ariporad/PIE-MiniProject2/images/graph.jpg

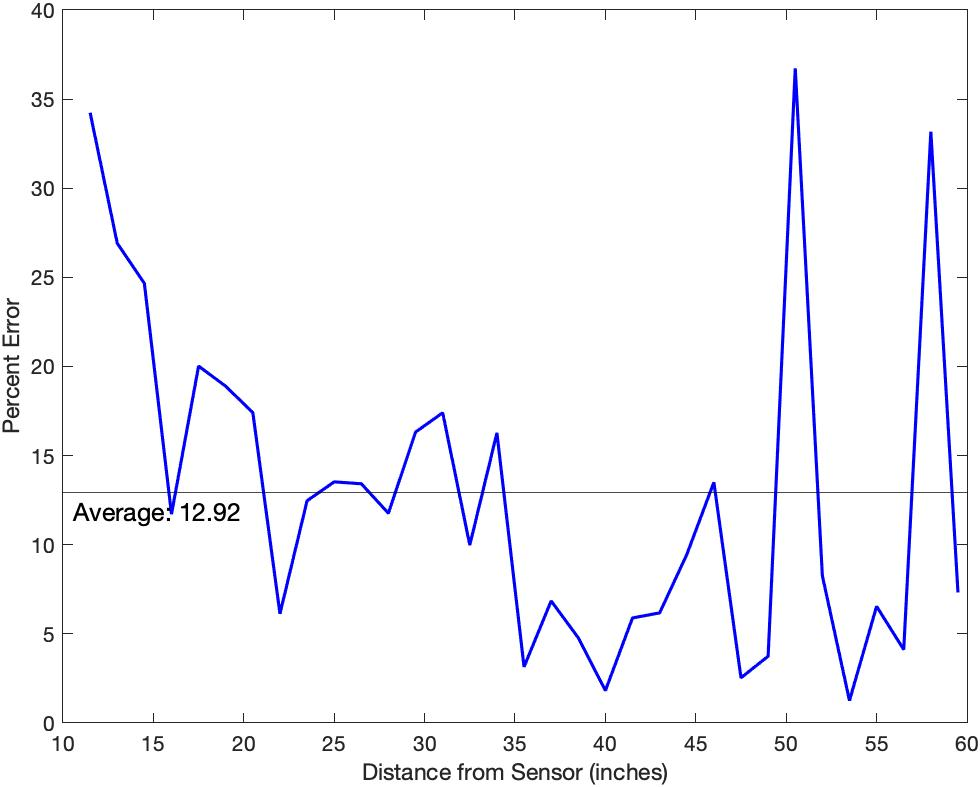
images/graph.jpg
