ariporad/PIE-MiniProject2/SW_files/inspiration.png

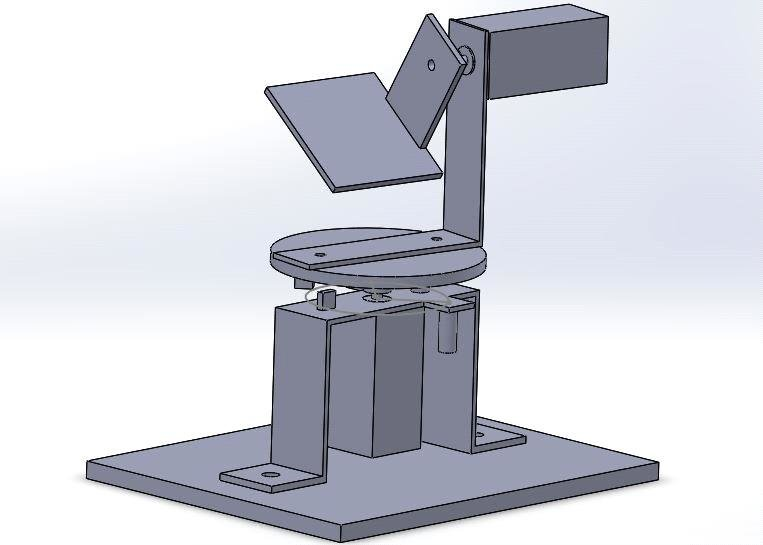
SW_files/inspiration.png
