ariporad/PIE-MiniProject2/SW_files/SensorAssem.SLDASM

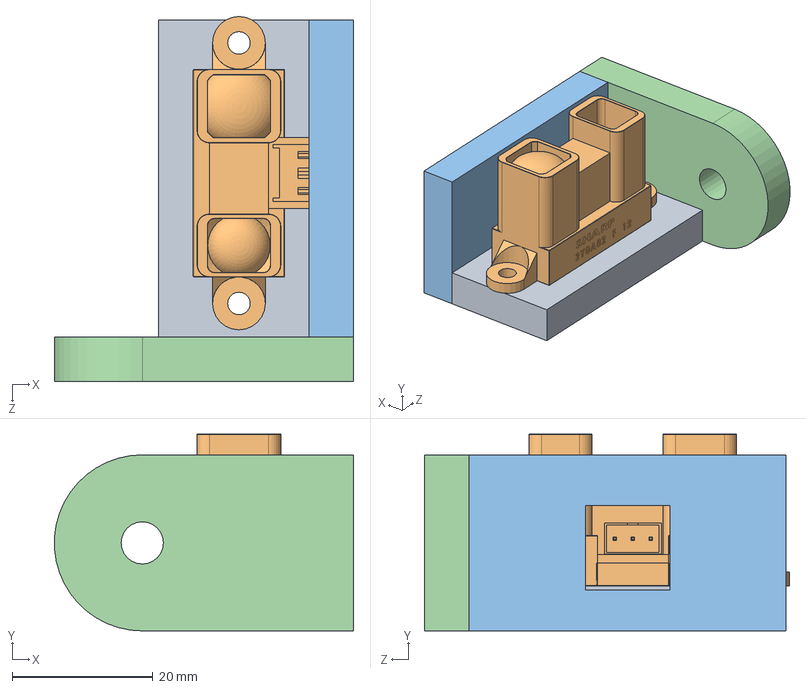
[picture p10: CAD file, 2021-09-24]
SW_files/SensorAssem.SLDASM
42.5 x 28.0 x 51.8 mm
SensorBack
SensorBottom
yServoSensorConnection
