ariporad/PIE-MiniProject2/SW_files/xServoBoxAssem.SLDASM

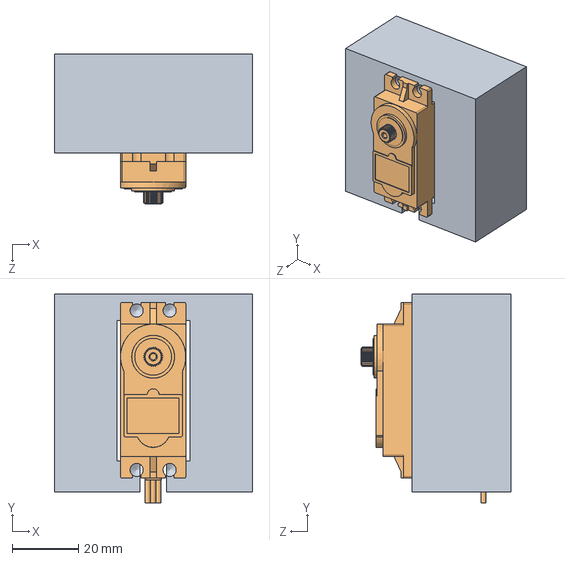
[picture p11: CAD file, 2021-09-24]
SW_files/xServoBoxAssem.SLDASM
60.0 x 63.3 x 45.4 mm
