ariporad/PIE-MiniProject2/SW_files/yServoAssem.SLDASM

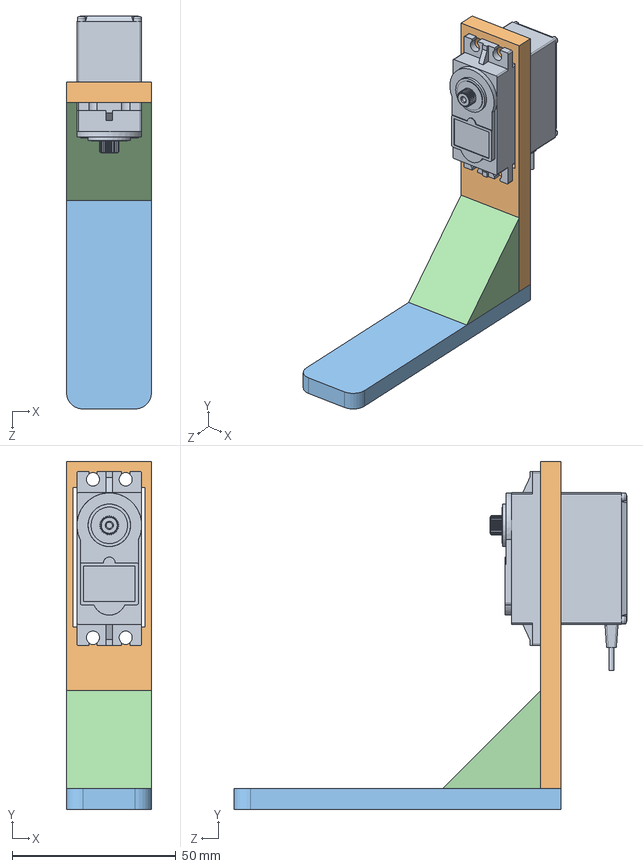
[picture p12: CAD file, 2021-09-24]
SW_files/yServoAssem.SLDASM
26.0 x 106.3 x 120.1 mm
yServoMount
xServoPlate
support
