ariporad/PIE-MiniProject2/SW_files/support.sldprt

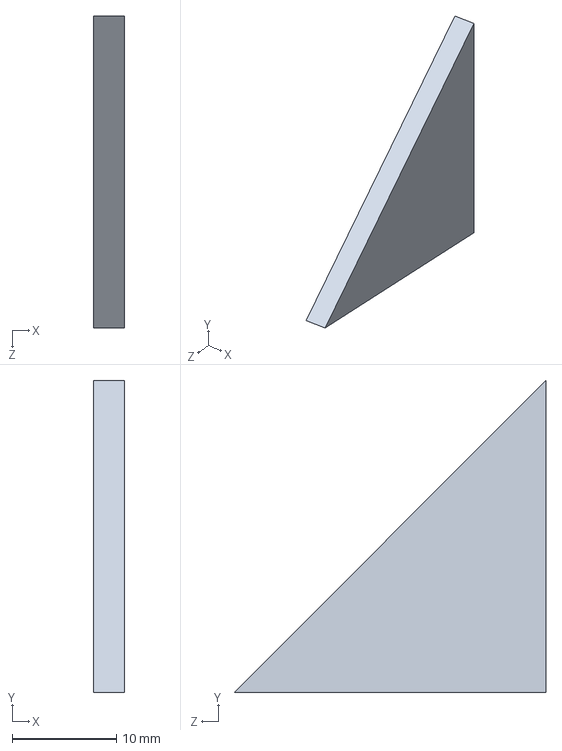
[picture p13: CAD file, 2021-09-24]
SW_files/support.sldprt
3.00 x 30.0 x 30.0 mm
