ariporad/PIE-MiniProject2/SW_files/ServoAssem.STL

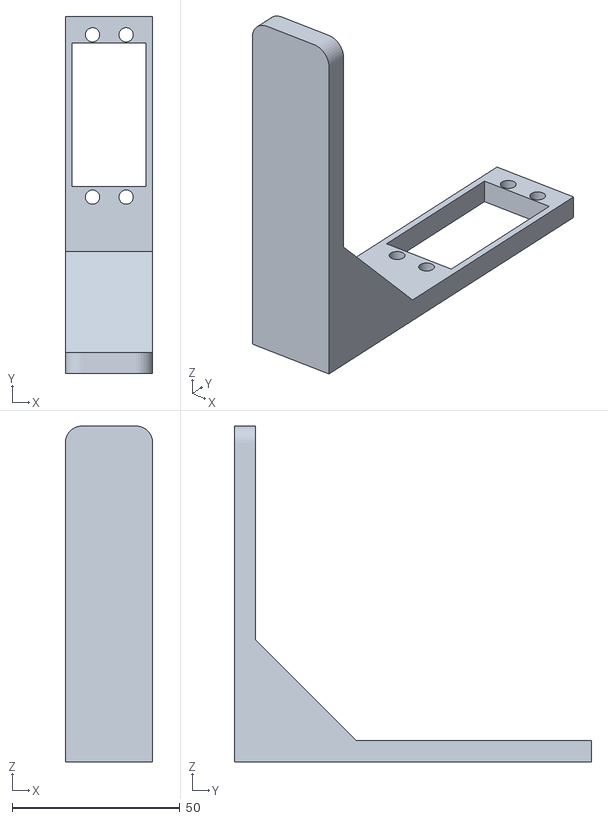
[picture p14: CAD file, 2021-09-24]
SW_files/ServoAssem.STL
26.0 x 106.3 x 100.0
