ariporad/PIE-MiniProject2/SW_files/xServoPlate.sldprt

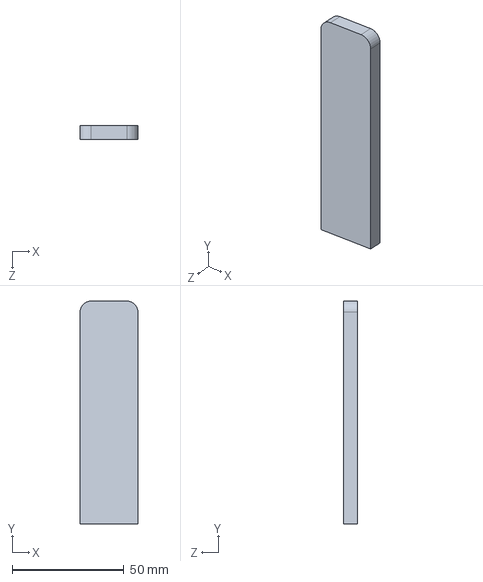
[picture p15: CAD file, 2021-09-24]
SW_files/xServoPlate.sldprt
26.0 x 100.0 x 6.35 mm
