ariporad/PIE-MiniProject2/SW_files/yServoMount.sldprt

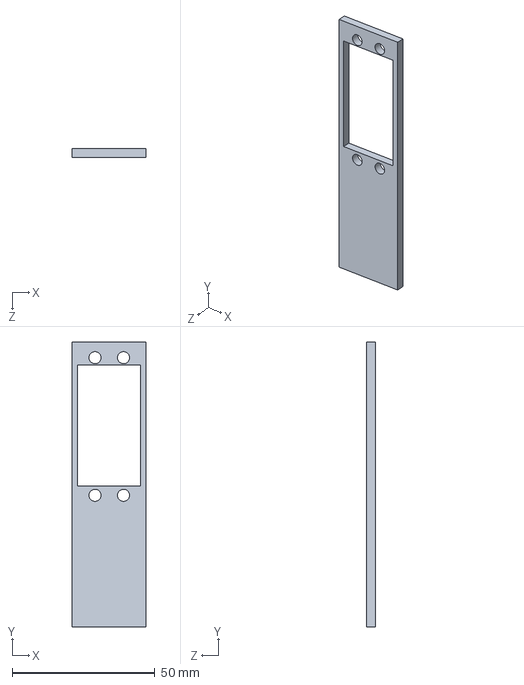
[picture p16: CAD file, 2021-09-24]
SW_files/yServoMount.sldprt
26.0 x 100.0 x 3.00 mm
