ariporad/PIE-MiniProject2/SW_files/xServoBox.sldprt

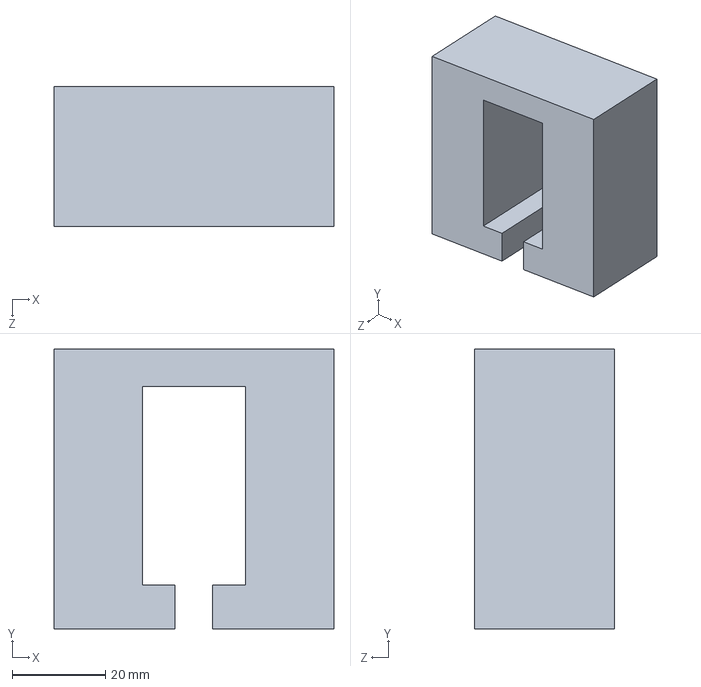
[picture p17: CAD file, 2021-09-24]
SW_files/xServoBox.sldprt
60.0 x 60.0 x 30.0 mm
