ariporad/PIE-MiniProject2/SW_files/SensorBack.SLDPRT

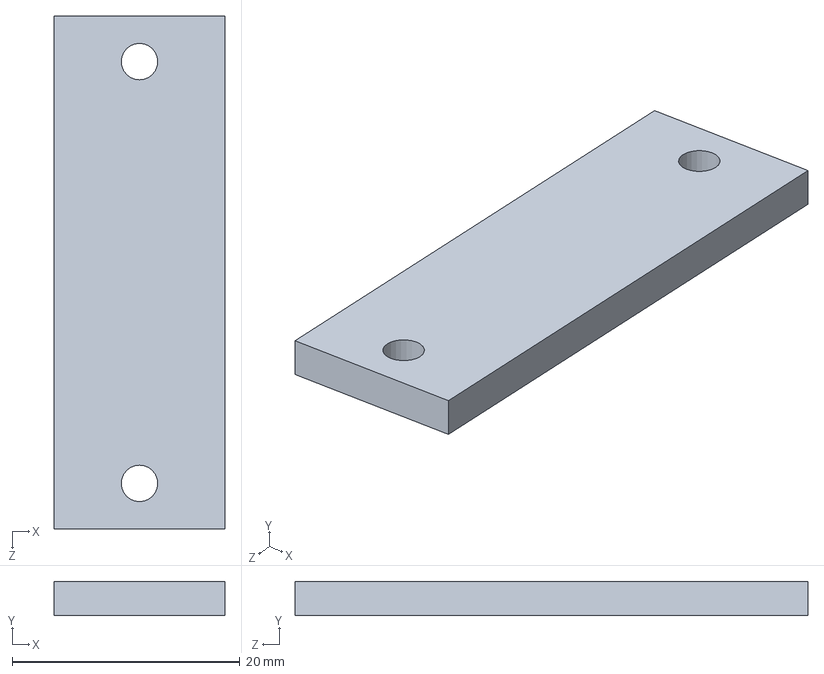
[picture p18: CAD file, 2021-09-20]
SW_files/SensorBack.SLDPRT
15.0 x 3.00 x 45.0 mm
