ariporad/PIE-MiniProject2/SW_files/HS-645_MG-Servo.SLDPRT

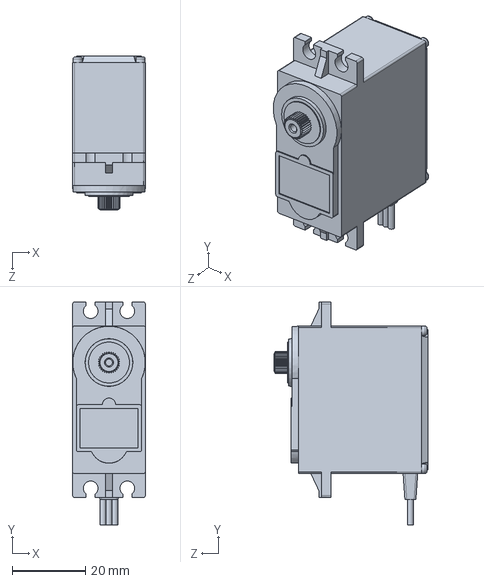
[picture p19: CAD file, 2021-09-20]
SW_files/HS-645_MG-Servo.SLDPRT
19.8 x 60.8 x 41.9 mm
