ariporad/PIE-MiniProject2/SW_files/SensorBottom.SLDPRT

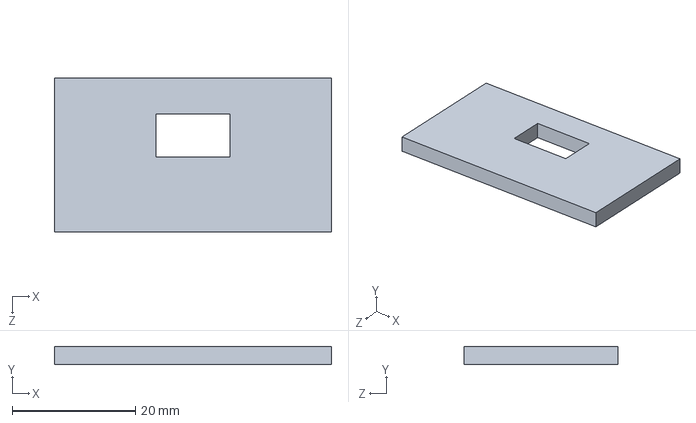
[picture p20: CAD file, 2021-09-20]
SW_files/SensorBottom.SLDPRT
45.0 x 3.00 x 25.0 mm
