ariporad/PIE-MiniProject2/SW_files/GP2Y0A02YK0F_SHARP.SLDPRT

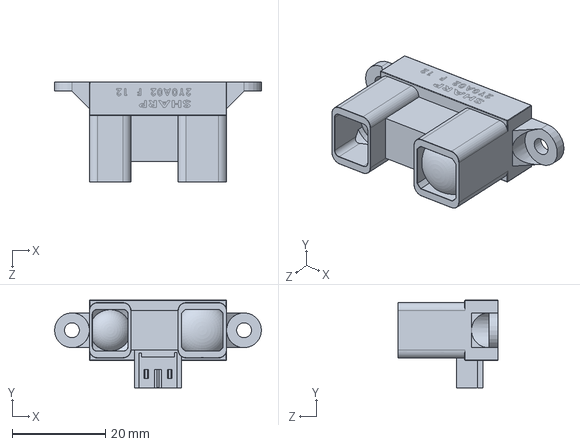
[picture p21: CAD file, 2021-09-20]
SW_files/GP2Y0A02YK0F_SHARP.SLDPRT
44.5 x 18.9 x 21.6 mm
