ariporad/PIE-MiniProject2/(list of files, cad)

Other CAD files:
SW_files/yServoSensorConnection.sldprt
SW_files/SensorAssem.STL
SW_files/xServoBoxAssem.STL
