ariporad/PIE-MiniProject2/mp2/Calibrator/calibrations/real1.csv

distance | sensorReading
6 | 156
9 | 109
12 | 124
15 | 111
18 | 285
21 | 244
24 | 209
27 | 187
30 | 171
33 | 152
36 | 140
39 | 128
42 | 117
45 | 108
48 | 101
51 | 89
54 | 69
57 | 69
60 | 50
63 | 65
66 | 62
