ariporad/PIE-MiniProject2/MATLAB/calibration_data.xlsx

Distance | Reading | Real Distance
72 | 160 | 69
69 | 148 | 66
66 | 22 | 63
63 | 20 | 60
60 | 38 | 57
57 | 12 | 54
54 | 10 | 51
51 | 16 | 48
48 | 20 | 45
45 | 29 | 42
42 | 54 | 39
39 | 86 | 36
36 | 119 | 33
33 | 174 | 30
30 | 221 | 27
27 | 270 | 24
24 | 290 | 21
21 | 291 | 18
18 | 323 | 15
15 | 396 | 12
12 | 480 | 9
9 | 560 | 6
6
