ariporad/PIE-MiniProject2/images/calibration.jpg

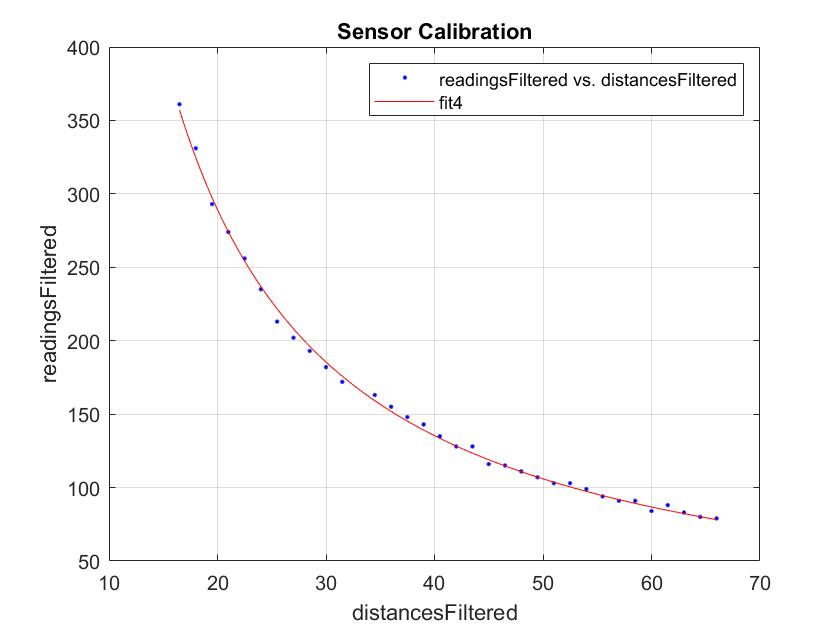
images/calibration.jpg
