ariporad/PIE-MiniProject2/(commit log)

2021-09-17 feat: calibration
2021-09-17 end of class
    [calibration_data.xlsx]
2021-09-20 Add SolidWorks files
    [GP2Y0A02YK0F_SHARP.SLDPRT, HS-645_MG-Servo.SLDPRT, PanTilt.SLDASM]
2021-09-20 Prototype mount for scanner
    [PanTilt.SLDASM, SensorAssem.SLDASM, SensorAssem.STL, SensorBack.SLDPRT, SensorBottom.SLDPRT, ServoAssem.STL, support.sldprt, yServoAssem.SLDASM]
2021-09-20 Thicken walls
    [SensorAssem.SLDASM, SensorAssem.STL, SensorBack.SLDPRT, SensorBottom.SLDPRT, ServoAssem.STL, support.sldprt, yServoAssem.SLDASM, yServoMount.sldprt]
2021-09-20 feat: add arduinolib, clean up and add some file structure
    [calibration_data.xlsx]
2021-09-20 refactor: make Scanner.py use ArduinoLib
2021-09-21 feat: allow writing an array of bytes to the arduino
2021-09-22 Add V2 CAD files for full assembly
    [SensorAssem.SLDASM, support.sldprt, xServoBox.sldprt, xServoBoxAssem.SLDASM, xServoPlate.sldprt, yServoAssem.SLDASM]
2021-09-22 Save files as .stl for 3D printing
    [ServoAssem.STL, support.sldprt, xServoBoxAssem.STL, xServoPlate.sldprt, yServoMount.sldprt]
2021-09-22 Add ServoAssem.STL for 3D printing
    [ServoAssem.STL, support.sldprt, xServoPlate.sldprt, yServoMount.sldprt]
2021-09-23 Finalize SW files
    [xServoBoxAssem.SLDASM]
2021-09-24 feat: calibratons
    [real1.csv, real2.csv]
2021-09-24 Add arduinoComPort variable
    to make it easier to run on either laptop
2021-09-24 Take final calibration and fit curve
    [calibration3.csv]
2021-09-24 Update calibration equation
2021-09-24 Nest sweeps
    TODO: figure out which angles to sweep between (currently full 0-180 deg)
2021-09-25 Visualize data in MATLAB
    [scan_1632596590.csv]
2021-09-25 Create folder for image files, add calibration plot
2021-09-25 Add high-density data file
    [scan_1632600507.csv]
2021-09-28 improve scanning
    [scan_1632596590.csv, scan_1632596682.csv, scan_1632600503.csv, scan_1632600507.csv, scan_1632782303.csv, scan_1632782697.csv]
2021-09-28 Add files for complete scan
    [scan_1632782303.csv, scan_1632782697.csv, scan_1632838405.csv, scan_1632838953.csv]
2021-09-28 It Works!
    [1d.csv, 5scans.csv, error.csv, good.csv, scan_1632838405.csv]
2021-09-28 Organize files, add final scans
    [1d.csv, 1scan.csv, error.csv, scan_1632596590.csv, scan_1632600507.csv, scan_1632782303.csv, scan_1632782697.csv, scan_1632838405.csv]
2021-09-30 WIP: report
    [calibration_data.xlsx]
